BebokBebop/FFT_Embedded_Systems/README.md

# FFT_Embedded_Systems

Project for Microprocessors and Embedded Systems course.
Display Fast Fourier Transform of microphone input on 8x3 LED matrix and on a SDS OLED display
